werksmini/EVFCamera/hardware/mainboard-test/netlist.csv

net | connections
+3V3 | J1.1 J1.17 J7.1
+5V | J1.2 J1.4 J2.1
BACK | J1.15 (GPIO 22) SW6.1
DOWN | J1.31 (GPIO 6) SW2.1
FN | J1.40 (GPIO 21) J5.1
GND | J1.6 J1.9 J1.14 J1.20 J1.25 J1.30 J1.34 J1.39 SW1.4 SW2.4 SW3.4 SW4.4 SW5.4 SW6.4 SW7.4 J2.2 J3.3 J4.4 J5.2 J6.4 J7.2
KNOB_A | J1.32 (GPIO 12) J6.1
KNOB_B | J1.36 (GPIO 16) J6.2
KNOB_PUSH | J1.38 (GPIO 20) J6.3
LEFT | J1.33 (GPIO 13) SW3.1
OK | J1.37 (GPIO 26) SW5.1
PLAY | J1.16 (GPIO 23) SW7.1
RIGHT | J1.35 (GPIO 19) SW4.1
SCL | J1.5 (GPIO 3) J7.4
SDA | J1.3 (GPIO 2) J7.3
SENSOR_INT | J1.7 (GPIO 4) J7.5
SHUTTER_FULL | J1.13 (GPIO 27) J3.2
SHUTTER_HALF | J1.11 (GPIO 17) J3.1
UP | J1.29 (GPIO 5) SW1.1
WHEEL_A | J1.18 (GPIO 24) J4.1
WHEEL_B | J1.22 (GPIO 25) J4.2
WHEEL_PUSH | J1.12 (GPIO 18) J4.3
