werksmini/EVFCamera/(commit log)

2026-11-11 Bench scripts, README, roadmap, SKRN footprint
    Preview, overlay and shutter-button test scripts from hardware bring-up,
    setup notes, the software roadmap, and the Alps SKRN KiCad footprint.
    Claude-Session: https://claude.ai/code/session_01QEH3AqRJCR4ZQuJ8pq1ace
2026-11-11 Defer fuel gauge and eye sensor
    Not in the first build: the MAX17048 plus the bq25185 take too much room.
    I2C pins stay free for later.
    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
2026-11-11 Milestone 1: app skeleton with modes, keyboard input and overlay
    evfcam/ package: Shoot, Magnify (5x/10x), Menu (page list) and basic
    Playback modes; input from the SSH terminal, any evdev keyboard and the
    GPIO 27 shutter; Picamera2 wrapper plus a FakeCamera for off-Pi work.
    Preview now uses the full-sensor 2028x1520 mode so framing matches photos.
    Thumb wheel (keys [ ]) sets exposure compensation. Photo names no longer
    collide when two shots land in the same second. Tests and a screen
    renderer included.
    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
    [__main__.py, actions.py, app.py, camcore.py, config.py, inputs.py, modes.py]
2026-11-11 Shutter feedback: border flash, optional review, EV limit warning
    At the shutter press the screen shows a dark frame with a white border and
    red dot until the photo is saved (waits one preview frame so the flash is
    on screen before the preview freezes). Optional review shows the preview
    frame grabbed at the press for --review seconds (off by default); any
    control ends it early. EV readout turns red with MAX when auto exposure is
    already using digital gain, so more +EV can't brighten the picture.
    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
2026-11-11 Milestone 2: settings and menu
    settings.py holds every user setting and saves it to
    ~/.config/evfcam/settings.json (atomic write; unknown or invalid values
    fall back to defaults). menu.py defines the six pages as data; the Menu
    mode edits values with left/right or the thumb wheel and runs actions.
    Settings applied to the camera: exposure mode (Auto, Shutter priority,
    Manual) via ExposureTimeMode/AnalogueGainMode, shutter, ISO, EV,
    metering, white balance, contrast, saturation, sharpness, black and white;
    long shutter speeds slow the preview frame rate. Still capture follows
    file format (RAW+JPEG saves a DNG too), JPEG quality and aspect ratio
    (sensor crop; 4:3 keeps the full 4056x3040). Sho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
2026-11-11 Keep settings through photo capture; drop in-frame value toasts
    Picamera2 resets controls to the configuration's own list on every mode
    switch, so settings applied with set_controls were lost when a photo was
    taken (black and white came out in colour, and the preview reverted
    after the shot). Settings are now stored in both the preview and still
    configurations, and capture switches modes explicitly so the way back
    uses the current preview configuration. Mock-Picamera2 test added.
    EV, shutter and ISO changes in Shoot mode no longer show a green message
    in the frame; the top bar already shows them.
    Claude-Session: https://claude.ai/code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
    [camcore.py, modes.py]
2026-11-11 Test mainboard v0.1 for Fusion Electronics (EAGLE .sch/.brd)
    Generated by hardware/mainboard-test/make_mainboard.py: Pi 2x20 header,
    D-pad (5 tact switches), Back/Menu, Play, and headers for power, shutter,
    thumb wheel, front Fn, top knob and I2C sensors, on an 80x56 mm
    single-sided through-hole board for CNC isolation milling. Placed and
    unrouted. Files pass the EAGLE DTD; nets follow the project GPIO map.
    preview.py draws the placement and airwires.
    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
    [mainboard_test.brd, mainboard_test.sch, netlist.csv]
2026-11-11 Mainboard: EAGLE library and command scripts to build it inside Fusion
    evfcam.lbr holds the parts; schematic.scr adds them with labelled net
    stubs in an open Fusion schematic; board.scr draws the 80x56 mm outline
    and places the parts in the PCB editor.
    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
2026-11-12 Lens study: 5 mm f/4 retrofocus wide for the HQ camera
    Four-element retrofocus (negative meniscus, stop, cemented doublet,
    singlet) traced and optimised with a small vectorised ray tracer.
    v1 reaches 6-14 um RMS blur over a 77 degree field with -19% distortion
    and 7.3 mm back clearance; limiting distortion trades away corner
    sharpness.
    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
2026-11-13 Grips: seeded SDF generator for bouldering-hold grips, contact sheets
    Front crimp (1x M2.5 + dowel) and rear thumb sloper (2x M2.5), flat mating
    face, checked wall/head/pin clearances, watertight STL via marching cubes.
    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
2026-11-14 Grips v2: smooth swept holds (crimp/pinch/sloper), 1- and 2-bolt, standard 10 mm pitch pattern
    Each grip is one continuous swept form (curved spine, tapered envelope, crimp/pinch/
    sloper section). Body pattern: M2.5 at y = -10/0/+10; 2-bolt grips use +/-10, 1-bolt
    grips use the centre with a set-screw locator at +10. v1 kept as gripgen_v1.py.
    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
2026-11-14 Grips: resize for slimmer body; rear to M2 on 5 mm pitch; tighter counterbores
    Front half as thick and 0.75 as wide (M2.5, cb 4.9, seat 1.8). Rear ~0.6 size,
    ~4.5 mm deep, M2 at -5/0/+5 (cb 4.1, seat 1.2). Bosses removed; spine centred
    (crimps: thick ridge) over the hole line; flatter crimp tops.
    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
